adafruit/Adafruit-Triple-LED-Matrix-Bonnet-PCB/Adafruit Triple LED Matrix Bonnet.brd

## EAGLE design Adafruit Triple LED Matrix Bonnet.brd (2025-07-08)

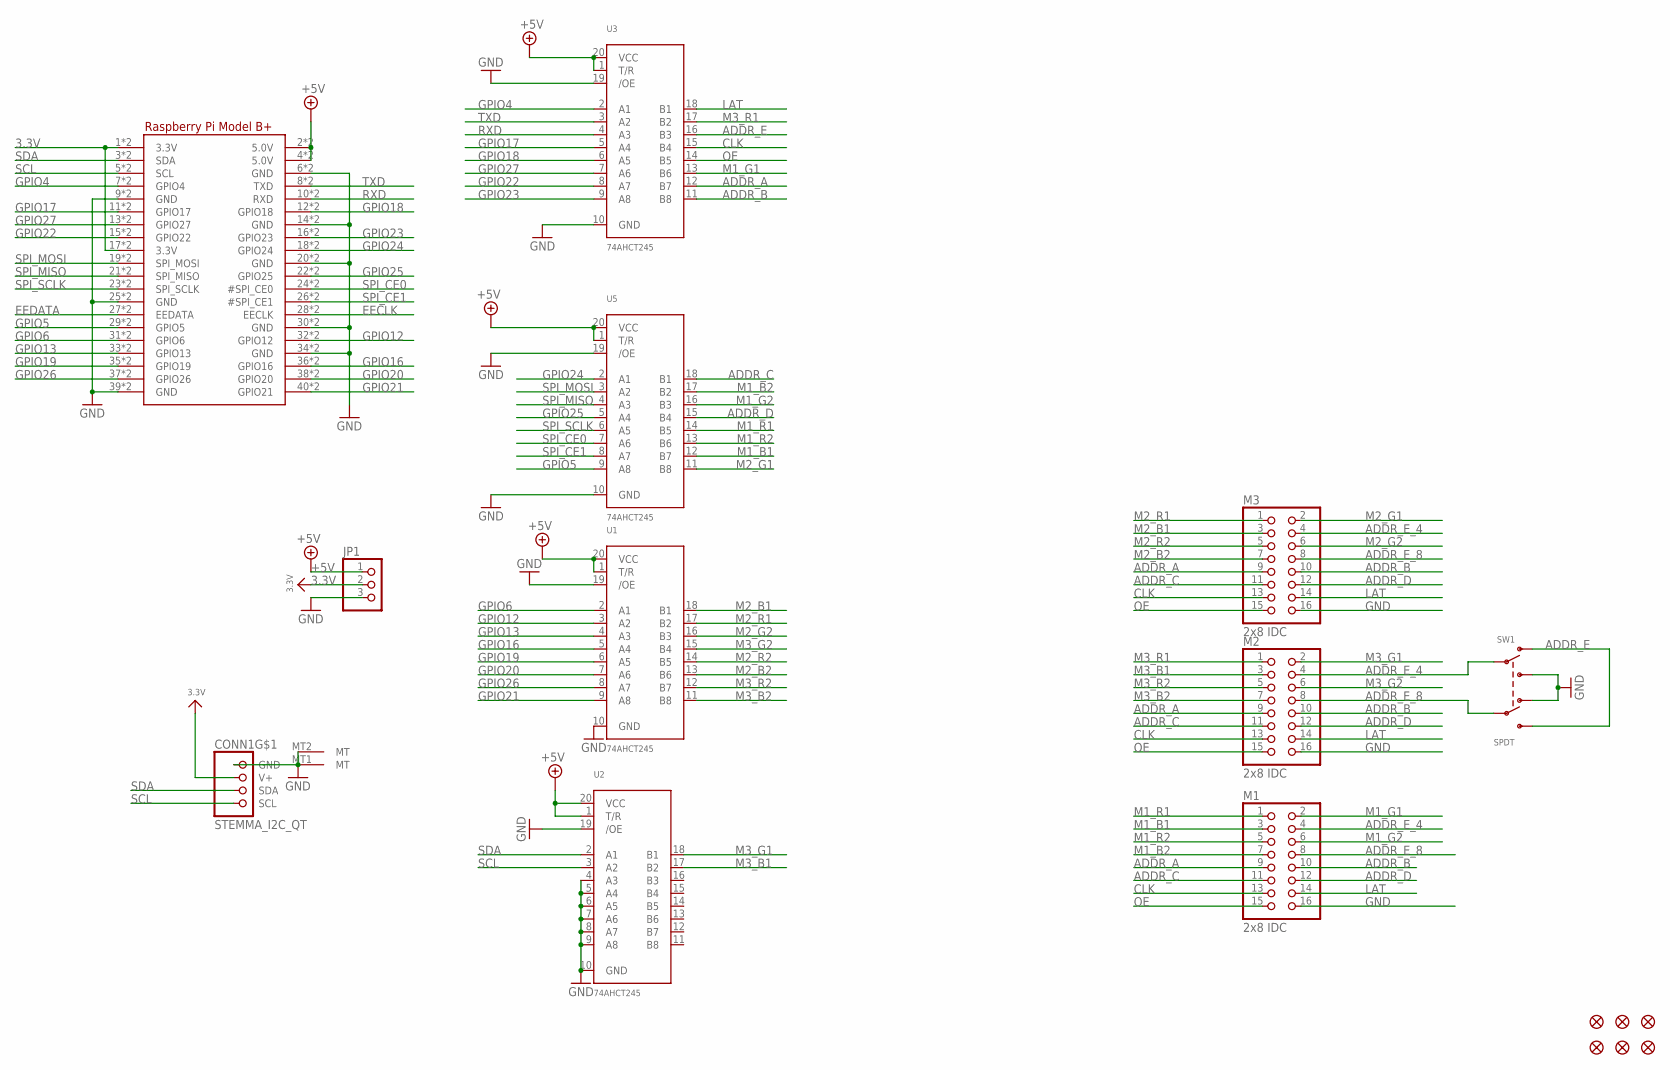
[picture p2: schematic Adafruit Triple LED Matrix Bonnet.sch]

Parts:
CONN1: STEMMA_I2C_QT; JST_SH4
FID1, FID2, FID3, FID4, FID5, FID6: FIDUCIAL_1MM
JP1: HEADER-1X376MIL; 1X03_ROUND_76
M1, M2, M3: 2x8 IDC; 2X08_SHROUDED
RPI1: RASPBERRYPI_BPLUS_2X20_THMSMT; RASPI_2X20_THMSMT
SW1: SPDT; EG1390
U1, U2, U3, U5: 74AHCT245; TSSOP20

Connections:
3.3V: CONN1.2 (V+), JP1.2, RPI1.1 (3.3V), RPI1.17 (3.3V), RPI1.S1 (3.3V), RPI1.S17 (3.3V)
+5V: JP1.1, RPI1.2 (5.0V), RPI1.4 (5.0V), RPI1.S2 (5.0V), RPI1.S4 (5.0V), U1.1 (T/R), U1.20 (VCC), U2.1 (T/R), U2.20 (VCC), U3.1 (T/R), U3.20 (VCC), U5.1 (T/R), U5.20 (VCC)
ADDR_A: M1.9, M2.9, M3.9, U3.12 (B7)
ADDR_B: M1.10, M2.10, M3.10, U3.11 (B8)
ADDR_C: M1.11, M2.11, M3.11, U5.18 (B1)
ADDR_D: M1.12, M2.12, M3.12, U5.15 (B4)
ADDR_E: SW1.O1, SW1.S2, U3.16 (B3)
ADDR_E_4: M1.4, M2.4, M3.4, SW1.P1
ADDR_E_8: M1.8, M2.8, M3.8, SW1.P2
CLK: M1.13, M2.13, M3.13, U3.15 (B4)
EECLK: RPI1.28 (EECLK), RPI1.S28 (EECLK)
EEDATA: RPI1.27 (EEDATA), RPI1.S27 (EEDATA)
GND: CONN1.1 (GND), CONN1.MT1 (MT), CONN1.MT2 (MT), JP1.3, M1.16, M2.16, M3.16, RPI1.6 (GND), RPI1.9 (GND), RPI1.14 (GND), RPI1.20 (GND), RPI1.25 (GND), RPI1.30 (GND), RPI1.34 (GND), RPI1.39 (GND), RPI1.S6 (GND), RPI1.S9 (GND), RPI1.S14 (GND), RPI1.S20 (GND), RPI1.S25 (GND), RPI1.S30 (GND), RPI1.S34 (GND), RPI1.S39 (GND), SW1.O2, SW1.S1, U1.10 (GND), U1.19 (/OE), U2.4 (A3), U2.5 (A4), U2.6 (A5), U2.7 (A6), U2.8 (A7), U2.9 (A8), U2.10 (GND), U2.19 (/OE), U3.10 (GND), U3.19 (/OE), U5.10 (GND), U5.19 (/OE)
GPIO4: RPI1.7 (GPIO4), RPI1.S7 (GPIO4), U3.2 (A1)
GPIO5: RPI1.29 (GPIO5), RPI1.S29 (GPIO5), U5.9 (A8)
GPIO6: RPI1.31 (GPIO6), RPI1.S31 (GPIO6), U1.2 (A1)
GPIO12: RPI1.32 (GPIO12), RPI1.S32 (GPIO12), U1.3 (A2)
GPIO13: RPI1.33 (GPIO13), RPI1.S33 (GPIO13), U1.4 (A3)
GPIO16: RPI1.36 (GPIO16), RPI1.S36 (GPIO16), U1.5 (A4)
GPIO17: RPI1.11 (GPIO17), RPI1.S11 (GPIO17), U3.5 (A4)
GPIO18: RPI1.12 (GPIO18), RPI1.S12 (GPIO18), U3.6 (A5)
GPIO19: RPI1.35 (GPIO19), RPI1.S35 (GPIO19), U1.6 (A5)
GPIO20: RPI1.38 (GPIO20), RPI1.S38 (GPIO20), U1.7 (A6)
GPIO21: RPI1.40 (GPIO21), RPI1.S40 (GPIO21), U1.9 (A8)
GPIO22: RPI1.15 (GPIO22), RPI1.S15 (GPIO22), U3.8 (A7)
GPIO23: RPI1.16 (GPIO23), RPI1.S16 (GPIO23), U3.9 (A8)
GPIO24: RPI1.18 (GPIO24), RPI1.S18 (GPIO24), U5.2 (A1)
GPIO25: RPI1.22 (GPIO25), RPI1.S22 (GPIO25), U5.5 (A4)
GPIO26: RPI1.37 (GPIO26), RPI1.S37 (GPIO26), U1.8 (A7)
GPIO27: RPI1.13 (GPIO27), RPI1.S13 (GPIO27), U3.7 (A6)
LAT: M1.14, M2.14, M3.14, U3.18 (B1)
M1_B1: M1.3, U5.12 (B7)
M1_B2: M1.7, U5.17 (B2)
M1_G1: M1.2, U3.13 (B6)
M1_G2: M1.6, U5.16 (B3)
M1_R1: M1.1, U5.14 (B5)
M1_R2: M1.5, U5.13 (B6)
M2_B1: M3.3, U1.18 (B1)
M2_B2: M3.7, U1.13 (B6)
M2_G1: M3.2, U5.11 (B8)
M2_G2: M3.6, U1.16 (B3)
M2_R1: M3.1, U1.17 (B2)
M2_R2: M3.5, U1.14 (B5)
M3_B1: M2.3, U2.17 (B2)
M3_B2: M2.7, U1.11 (B8)
M3_G1: M2.2, U2.18 (B1)
M3_G2: M2.6, U1.15 (B4)
M3_R1: M2.1, U3.17 (B2)
M3_R2: M2.5, U1.12 (B7)
OE: M1.15, M2.15, M3.15, U3.14 (B5)
RXD: RPI1.10 (RXD), RPI1.S10 (RXD), U3.4 (A3)
SCL: CONN1.4 (SCL), RPI1.5 (SCL), RPI1.S5 (SCL), U2.3 (A2)
SDA: CONN1.3 (SDA), RPI1.3 (SDA), RPI1.S3 (SDA), U2.2 (A1)
SPI_CE0: RPI1.24 (#SPI_CE0), RPI1.S24 (#SPI_CE0), U5.7 (A6)
SPI_CE1: RPI1.26 (#SPI_CE1), RPI1.S26 (#SPI_CE1), U5.8 (A7)
SPI_MISO: RPI1.21 (SPI_MISO), RPI1.S21 (SPI_MISO), U5.4 (A3)
SPI_MOSI: RPI1.19 (SPI_MOSI), RPI1.S19 (SPI_MOSI), U5.3 (A2)
SPI_SCLK: RPI1.23 (SPI_SCLK), RPI1.S23 (SPI_SCLK), U5.6 (A5)
TXD: RPI1.8 (TXD), RPI1.S8 (TXD), U3.3 (A2)

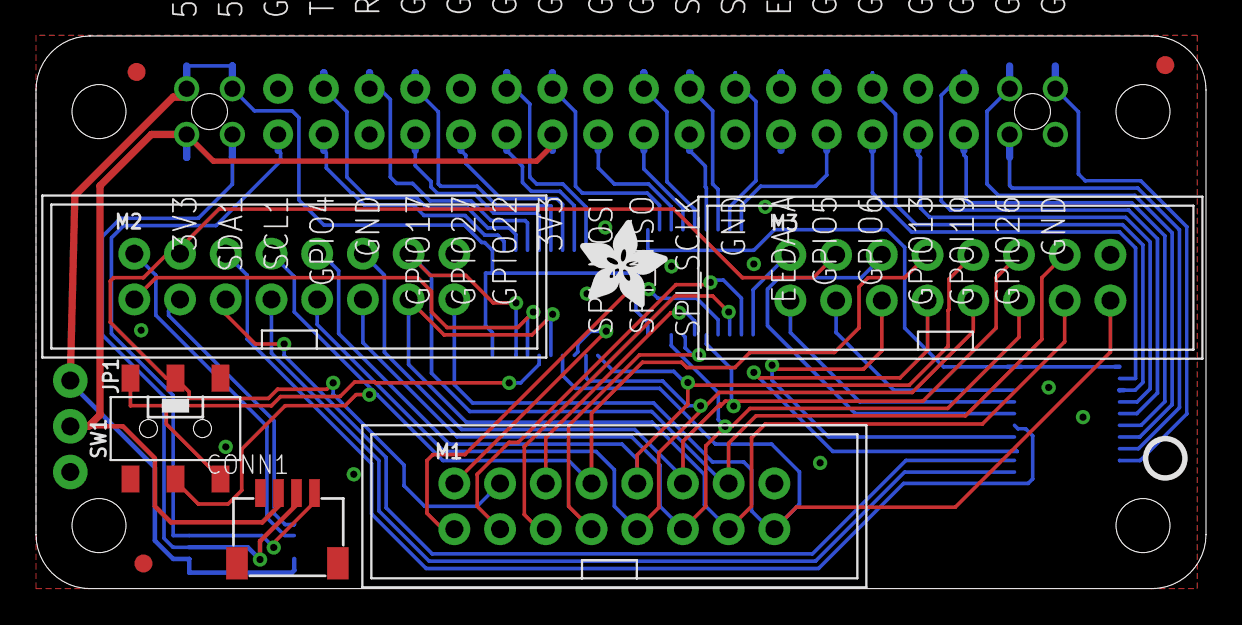
[picture p3: board Adafruit Triple LED Matrix Bonnet.brd from above]

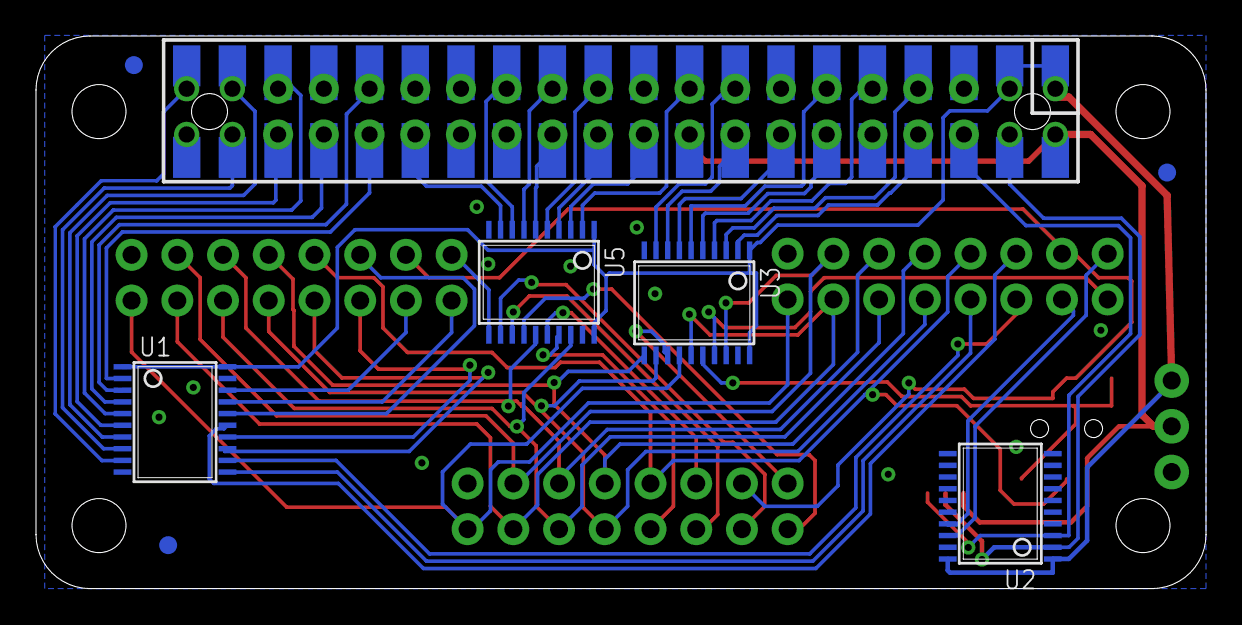
[picture p4: board Adafruit Triple LED Matrix Bonnet.brd from below]

Board: 2 copper layers, 65.0 x 30.7 mm, 84 parts (61 on the bottom side), 59 nets.

Other parts of the board:
PLABEL0: PLABEL0
PLABEL1: PLABEL1
PLABEL2: PLABEL2
PLABEL3: PLABEL3
PLABEL4: PLABEL4
PLABEL5: PLABEL5
PLABEL6: PLABEL6
PLABEL7: PLABEL7
PLABEL8: PLABEL8
PLABEL9: PLABEL9
PLABEL10: PLABEL10
PLABEL11: PLABEL11
PLABEL12: PLABEL12
PLABEL13: PLABEL13
PLABEL14: PLABEL14
PLABEL15: PLABEL15
PLABEL16: PLABEL16
PLABEL17: PLABEL17
PLABEL18: PLABEL18
PLABEL19: PLABEL19
PLABEL20: PLABEL20
PLABEL21: PLABEL21
PLABEL22: PLABEL22
PLABEL23: PLABEL23
PLABEL24: PLABEL24
PLABEL25: PLABEL25
PLABEL26: PLABEL26
PLABEL27: PLABEL27
PLABEL28: PLABEL28
PLABEL29: PLABEL29
PLABEL30: PLABEL30
PLABEL31: PLABEL31
PLABEL32: PLABEL32
PLABEL33: PLABEL33
PLABEL34: PLABEL34
PLABEL35: PLABEL35
PLABEL36: PLABEL36
PLABEL37: PLABEL37
PLABEL38: PLABEL38
PLABEL39: PLABEL39
PLABEL40: PLABEL40
PLABEL41: PLABEL41
PLABEL42: PLABEL42
PLABEL43: PLABEL43
PLABEL44: PLABEL44
PLABEL45: PLABEL45
PLABEL46: PLABEL46
PLABEL47: PLABEL47
PLABEL48: PLABEL48
PLABEL49: PLABEL49
PLABEL50: PLABEL50
PLABEL51: PLABEL51
PLABEL52: PLABEL52
PLABEL53: PLABEL53
PLABEL54: PLABEL54
PLABEL55: PLABEL55
PLABEL56: PLABEL56
PLABEL57: PLABEL57
PLABEL58: PLABEL58
PLABEL59: PLABEL59
PLABEL60: PLABEL60
PLABEL61: PLABEL61
PLABEL62: PLABEL62
PLABEL63: PLABEL63
PLABEL64: PLABEL64
U$2: ADAFRUIT_5MM
U$3: PCBFEAT-REV-056
